robot-army/LoRaWAN_GPS/MiniUltraPro-master/MINI-ULTRA-PRO.pdf

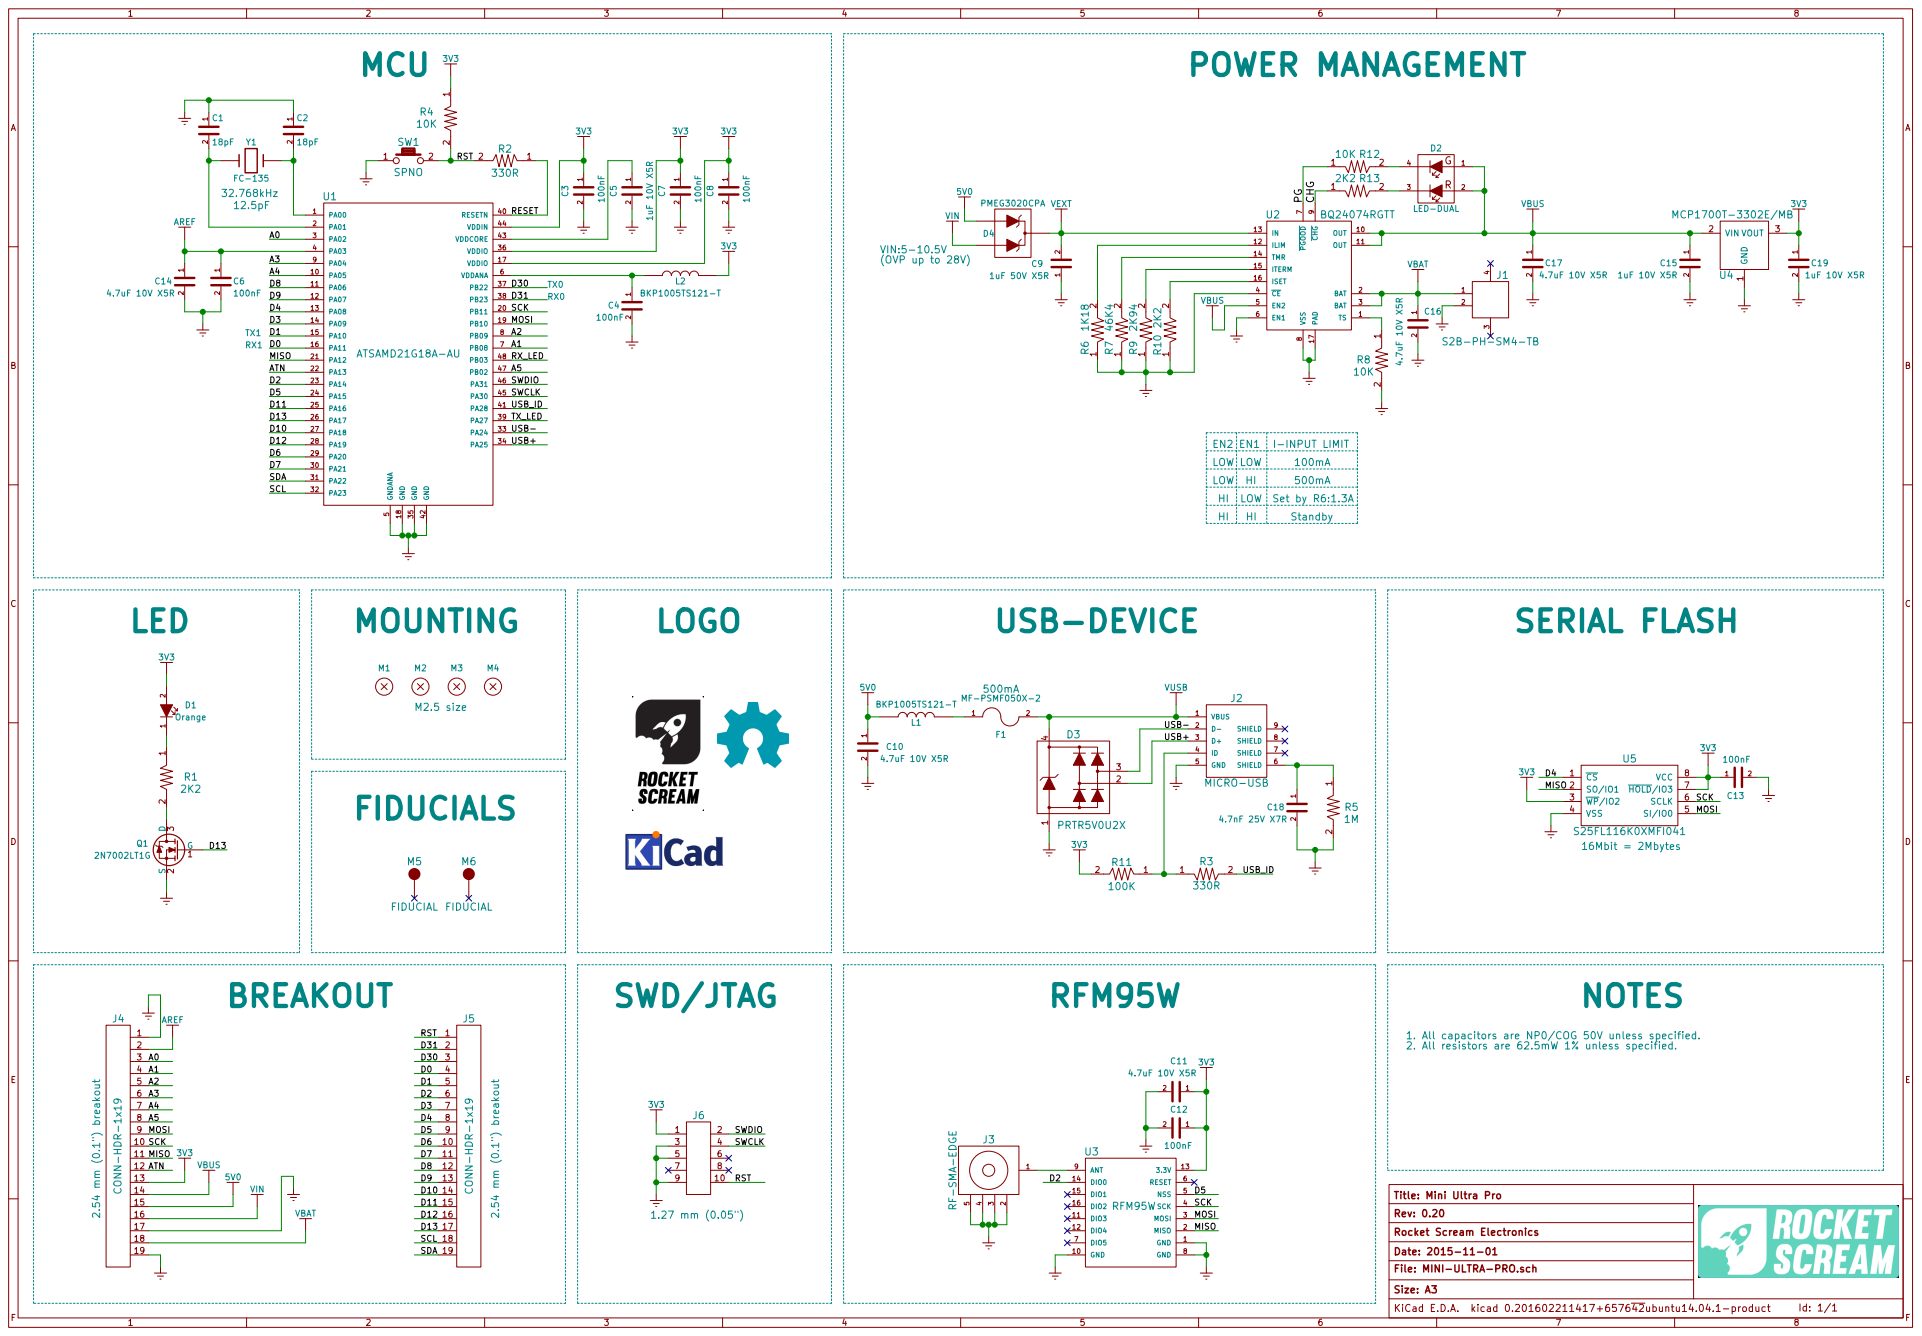
[picture p1: page 1]

5 VDDANA 6 PB08 7 PB09 8 PA04 9 PA05 10 PB11 20 PA21 30 RESETN 40 PA06 11 PA12 21 PA22 31 PA28 41 PA07 12 PA13 22 PA23 32 GND 42 PA08 13 PA14 23 PA24 33 VDDCORE 43 PA09 14 PA15 24 PA25 34 VDDIN 44 PA10 15 PA16 25 GND 35 PA30 45 PA11 16 PA17 26 VDDIO 36 PA31 46 VDDIO 17 PA18 27 PB22 37 PB02 47 GND 18 PA19 28 PB23 38 PB03 48 PB10 19 PA20 29 PA27 39 U1 ATSAMD21G18A-AU

100mA
500mA
Set by R6:1.3A

1. All capacitors are NP0/COG 50V unless specified.
2. All resistors are 62.5mW 1% unless specified.

Id: 1/1 Title: Mini Ultra Pro
F Date: 2015-11-01 KiCad E.D.A. kicad 0.201602211417+657642ubuntu14.04.1-product Rev: 0.20 Size: A3
File: MINI-ULTRA-PRO.sch Rocket Scream Electronics
