robot-army/LoRaWAN_GPS/lorawan_gps.kicad_pcb

## KiCad design lorawan_gps.kicad_pcb (2016-05-09)

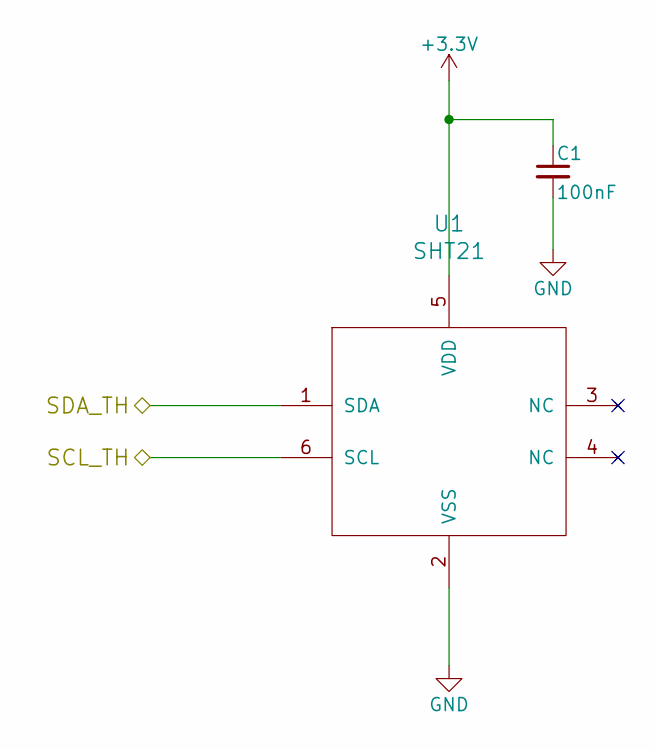
[picture p2: schematic TempHumidity.sch]

Parts:
C1: 100nF; C_0603
U1: SHT21

Connections:
/MCU/MPU_SCL: U1.6 (SCL); also elsewhere on the board
/MCU/MPU_SDA: U1.1 (SDA); also elsewhere on the board
GND: C1.2, U1.2 (VSS); also elsewhere on the board

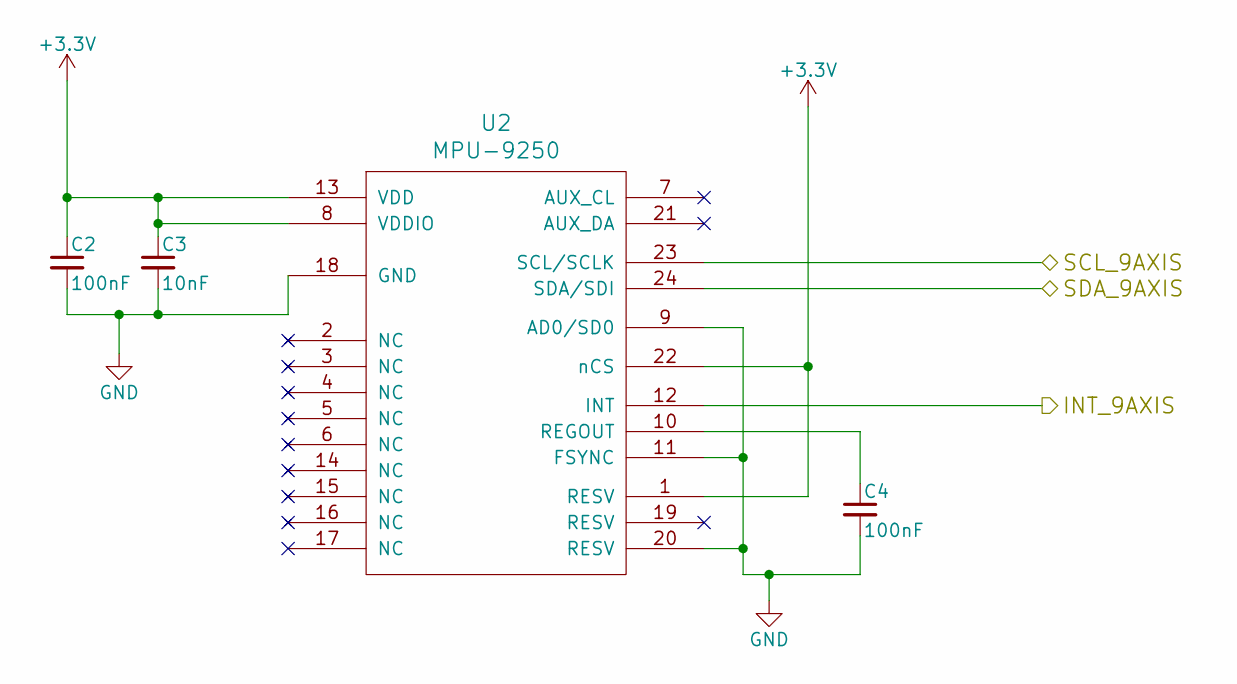
[picture p3: schematic 9axis.sch]

Parts:
C2, C4: 100nF; C_0603
C3: 10nF; C_0603
U2: MPU-9250; QFN-24-1EP_3x3mm_Pitch0.4mm

Connections:
/9axis/INT_9AXIS: U2.12 (INT); also elsewhere on the board
/MCU/MPU_SCL: U2.23 (SCL/SCLK); also elsewhere on the board
/MCU/MPU_SDA: U2.24 (SDA/SDI); also elsewhere on the board
GND: C2.2, C3.2, C4.2, U2.9 (AD0/SD0), U2.11 (FSYNC), U2.18 (GND), U2.20 (RESV); also elsewhere on the board
unnamed: C4.1, U2.10 (REGOUT)

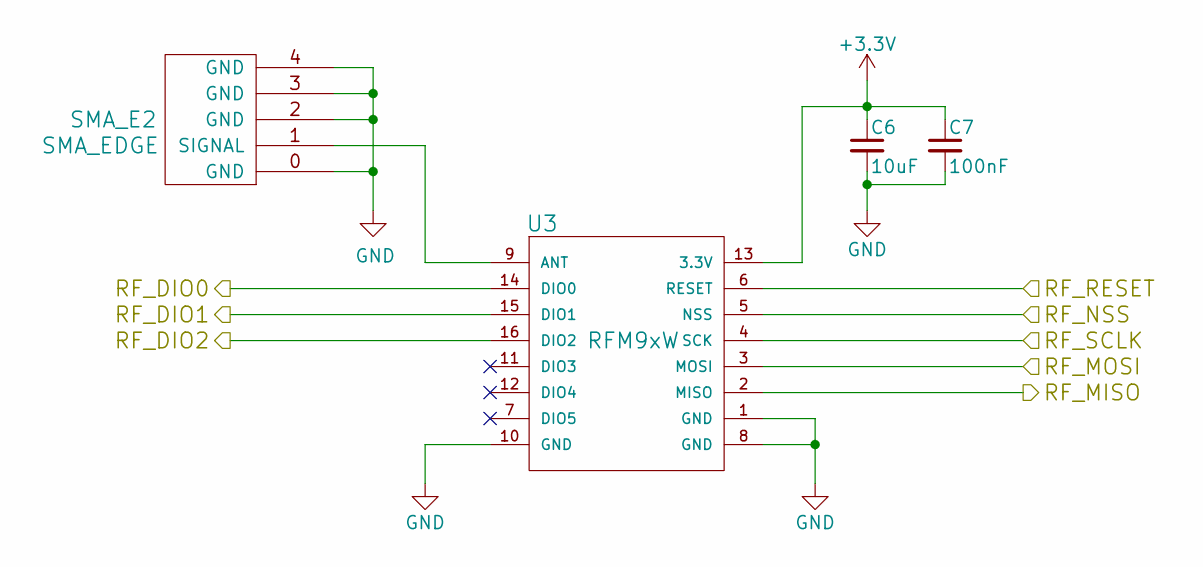
[picture p4: schematic LoRaWAN.sch]

Parts:
C6: 10uF; C_0805
C7: 100nF; C_0603
SMA_E2: SMA_EDGE
U3: RFM9xW

Connections:
/MCU/MPU_D14: U3.6 (RESET); also elsewhere on the board
/MCU/MPU_IN14: U3.15 (DIO1); also elsewhere on the board
/MCU/MPU_INT5: U3.16 (DIO2); also elsewhere on the board
/MCU/MPU_INT9: U3.14 (DIO0); also elsewhere on the board
/MCU/MPU_MISO: U3.2 (MISO); also elsewhere on the board
/MCU/MPU_MOSI: U3.3 (MOSI); also elsewhere on the board
/MCU/MPU_SCK: U3.4 (SCK); also elsewhere on the board
/MCU/MPU_SS: U3.5 (NSS); also elsewhere on the board
GND: C6.2, C7.2, SMA_E2.0 (GND), SMA_E2.2 (GND), SMA_E2.3 (GND), SMA_E2.4 (GND), U3.1 (GND), U3.8 (GND), U3.10 (GND); also elsewhere on the board
unnamed 22: SMA_E2.1 (SIGNAL), U3.9 (ANT); also elsewhere on the board

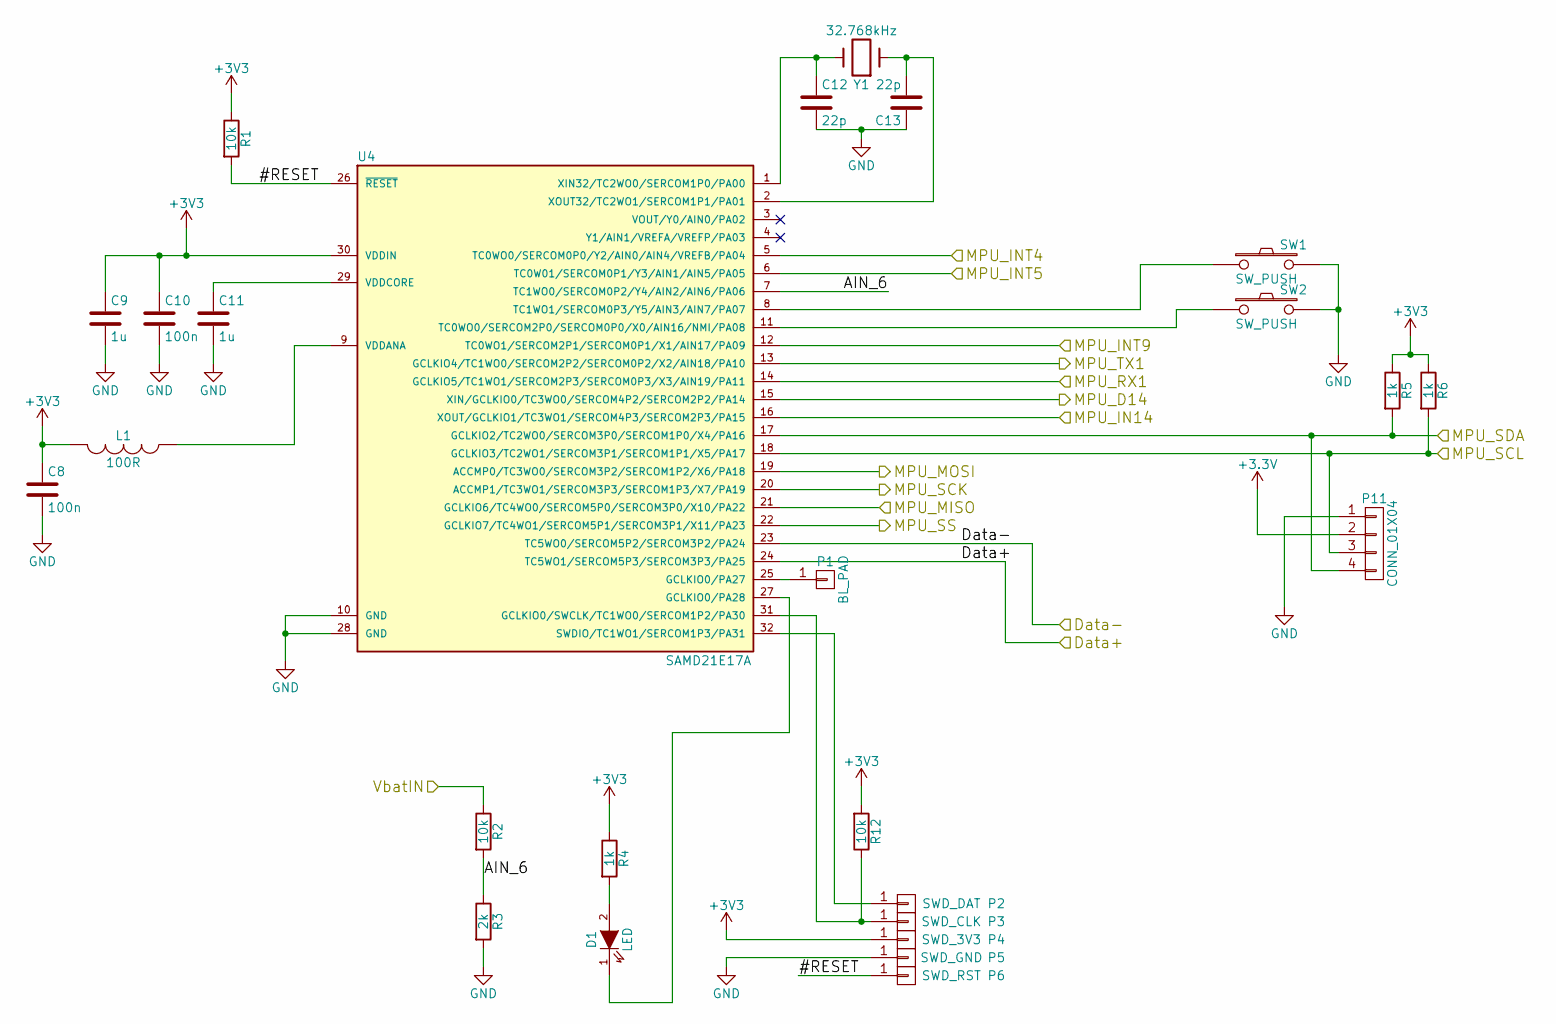
[picture p5: schematic MPU.sch]

Parts:
C8, C10: 100n; C_0603
C9, C11: 1u; C_0603
C12, C13: 22p; C_0603
D1: LED; C_0603
L1: 100R; C_0603
P1: BL_PAD; Measurement_Point_Round-TH_Small
P2: SWD_DAT; Measurement_Point_Round-TH_Small
P3: SWD_CLK; Measurement_Point_Round-TH_Small
P4: SWD_3V3; Measurement_Point_Round-TH_Small
P5: SWD_GND; Measurement_Point_Round-TH_Small
P6: SWD_RST; Measurement_Point_Round-TH_Small
P11: CONN_01X04; Pin_Header_Straight_1x04
R1, R2, R12: 10k; C_0603
R3: 2k; C_0603
R4, R5, R6: 1k; C_0603
SW1, SW2: SW_PUSH; SW_SPST_EVQP2
U4: SAMD21E17A; QFN-32-1EP_5x5mm_Pitch0.5mm
Y1: 32.768kHz; ABS07

Connections:
/9axis/INT_9AXIS: U4.5 (TC0WO0/SERCOM0P0/Y2/AIN0/AIN4/VREFB/PA04); also elsewhere on the board
/Battery and USB Connector/D+: U4.24 (TC5WO1/SERCOM5P3/SERCOM3P3/PA25); also elsewhere on the board
/Battery and USB Connector/D-: U4.23 (TC5WO0/SERCOM5P2/SERCOM3P2/PA24); also elsewhere on the board
/Battery and USB Connector/V_BAT: R2.1; also elsewhere on the board
/Battery and USB Connector/V_USB_Sense: U4.3 (VOUT/Y0/AIN0/PA02); also elsewhere on the board
/MCU/#RESET: P6.1, R1.2, U4.26 (~RESET~)
/MCU/AIN_6: R2.2, R3.1, U4.7 (TC1WO0/SERCOM0P2/Y4/AIN2/AIN6/PA06)
/MCU/MPU_D14: U4.15 (XIN/GCLKIO0/TC3WO0/SERCOM4P2/SERCOM2P2/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); also elsewhere on the board
/MCU/MPU_IN14: U4.16 (XOUT/GCLKIO1/TC3WO1/SERCOM4P3/SERCOM2P3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); also elsewhere on the board
/MCU/MPU_INT5: U4.6 (TC0W01/SERCOM0P1/Y3/AIN1/AIN5/PA05); also elsewhere on the board
/MCU/MPU_INT9: U4.12 (TC0WO1/SERCOM2P1/SERCOM0P1/X1/AIN17/PA09); also elsewhere on the board
/MCU/MPU_MISO: U4.21 (GCLKIO6/TC4WO0/SERCOM5P0/SERCOM3P0/X10/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); also elsewhere on the board
/MCU/MPU_MOSI: U4.19 (ACCMP0/TC3WO0/SERCOM3P2/SERCOM1P2/X6/PA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); also elsewhere on the board
/MCU/MPU_RX1: U4.14 (GCLKIO5/TC1WO1/SERCOM2P3/SERCOM0P3/X3/A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); also elsewhere on the board
/MCU/MPU_SCK: U4.20 (ACCMP1/TC3WO1/SERCOM3P3/SERCOM1P3/X7/PA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); also elsewhere on the board
/MCU/MPU_SCL: P11.3, R6.2, U4.18 (GCLKIO3/TC2WO1/SERCOM3P1/SERCOM1P1/X5/P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); also elsewhere on the board
/MCU/MPU_SDA: P11.4, R5.2, U4.17 (GCLKIO2/TC2WO0/SERCOM3P0/SERCOM1P0/X4/P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); also elsewhere on the board
/MCU/MPU_SS: U4.22 (GCLKIO7/TC4WO1/SERCOM5P1/SERCOM3P1/X11/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); also elsewhere on the board
/MCU/MPU_TX1: U4.13 (GCLKIO4/TC1WO0/SERCOM2P2/SERCOM0P2/X2/A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); also elsewhere on the board
GND: C8.2, C9.2, C10.2, C11.2, C12.2, C13.1, P5.1, P11.1, R3.2, SW1.2, SW2.2, U4.10 (GND), U4.28 (GND); also elsewhere on the board
unnamed: C11.1, U4.29 (VDDCORE)
unnamed: C12.1, U4.1 (XIN32/TC2WO0/SERCOM1P0/PA00), Y1.2
unnamed: C13.2, U4.2 (XOUT32/TC2WO1/SERCOM1P1/PA01), Y1.1
unnamed: D1.1 (K), U4.27 (GCLKIO0/PA28)
unnamed: D1.2 (A), R4.2
unnamed: L1.1, U4.9 (VDDANA)
unnamed: P1.1, U4.25 (GCLKIO0/PA27)
unnamed: P2.1, U4.32 (SWDIO/TC1WO1/SERCOM1P3/PA31)
unnamed: P3.1, R12.1, U4.31 (GCLKIO0/SWCLK/TC1WO0/SERCOM1P2/PA30)
unnamed: SW1.1, U4.8 (TC1WO1/SERCOM0P3/Y5/AIN3/AIN7/PA07)
unnamed: SW2.1, U4.11 (TC0WO0/SERCOM2P0/SERCOM0P0/X0/AIN16/NMI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)

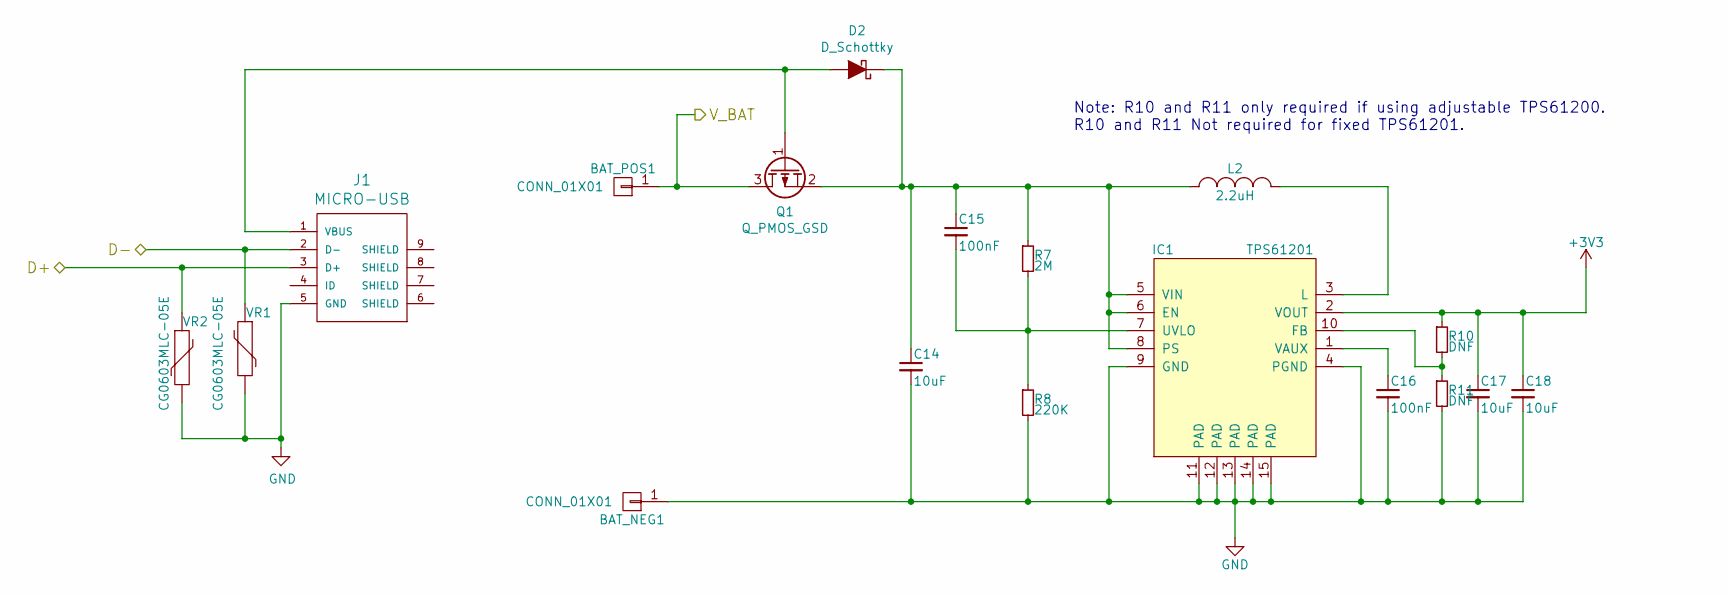
[picture p6: schematic Battery.sch]

Parts:
BAT_NEG1: CONN_01X01; Measurement_Point_Round-TH_Small
BAT_POS1: CONN_01X01; Measurement_Point_Round-TH_Small
C14, C17, C18: 10uF; C_0805
C15, C16: 100nF; C_0603
D2: D_Schottky; SOD-323; MFG Part Number MSS1P2L
IC1: TPS61201; VSON-10-1(4)EP_3x3mm_Pitch0.5mm
J1: MICRO-USB
L2: 2.2uH; Neosid_Inductor_SMS-ME3015
Q1: Q_PMOS_GSD; SOT-23; MFG Part Number FDN340P
R7: 2M; C_0603
R8: 220K; C_0603
R10, R11: DNF; C_0603
VR1, VR2: CG0603MLC-05E; C_0603

Connections:
/Battery and USB Connector/D+: J1.3 (D+), VR2.1; also elsewhere on the board
/Battery and USB Connector/D-: J1.2 (D-), VR1.1; also elsewhere on the board
/Battery and USB Connector/V_BAT: BAT_POS1.1, Q1.3 (D); also elsewhere on the board
GND: BAT_NEG1.1, C14.2, C16.2, C17.2, C18.2, IC1.4 (PGND), IC1.9 (GND), IC1.11 (PAD), IC1.12 (PAD), IC1.13 (PAD), IC1.14 (PAD), IC1.15 (PAD), J1.5 (GND), R8.2, R11.2, VR1.2, VR2.2; also elsewhere on the board
unnamed: C14.1, C15.1, D2.1 (K), IC1.5 (VIN), IC1.6 (EN), IC1.8 (PS), L2.1, Q1.2 (S), R7.1
unnamed: C15.2, IC1.7 (UVLO), R7.2, R8.1
unnamed: C16.1, IC1.1 (VAUX)
unnamed 32: D2.2 (A), J1.1 (VBUS), Q1.1 (G); also elsewhere on the board
unnamed: IC1.3 (L), L2.2
unnamed: IC1.10 (FB), R10.2, R11.1

Notes on the sheet:
Note: R10 and R11 only required if using adjustable TPS61200. R10 and R11 Not required for fixed TPS61201.

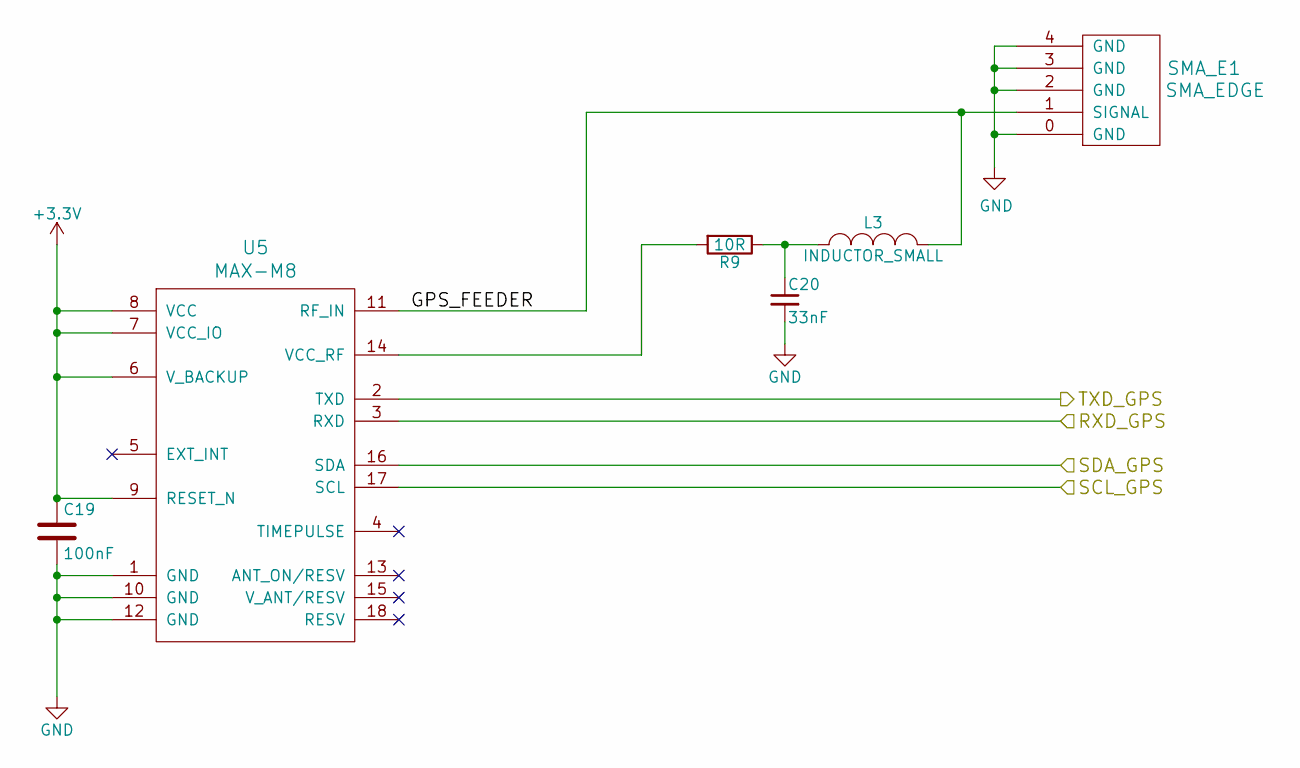
[picture p7: schematic GPS.sch]

Parts:
C19: 100nF; C_0603
C20: 33nF; C_0603
L3: INDUCTOR_SMALL; C_0603
R9: 10R; C_0603
SMA_E1: SMA_EDGE
U5: MAX-M8

Connections:
/GPS/GPS_FEEDER: L3.2, SMA_E1.1 (SIGNAL), U5.11 (RF_IN); also elsewhere on the board
/MCU/MPU_RX1: U5.2 (TXD); also elsewhere on the board
/MCU/MPU_SCL: U5.17 (SCL); also elsewhere on the board
/MCU/MPU_SDA: U5.16 (SDA); also elsewhere on the board
/MCU/MPU_TX1: U5.3 (RXD); also elsewhere on the board
GND: C19.2, C20.2, SMA_E1.0 (GND), SMA_E1.2 (GND), SMA_E1.3 (GND), SMA_E1.4 (GND), U5.1 (GND), U5.10 (GND), U5.12 (GND); also elsewhere on the board
unnamed: C20.1, L3.1, R9.1
unnamed: R9.2, U5.14 (VCC_RF)

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
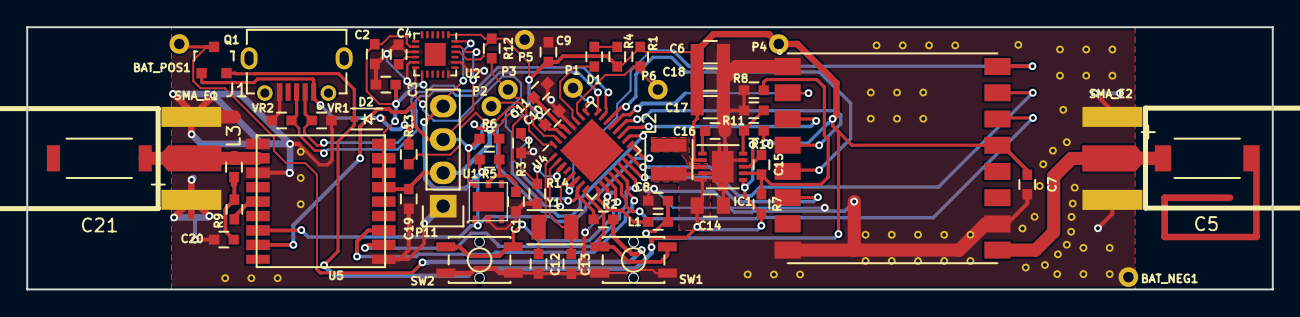
[picture p8: board lorawan_gps.kicad_pcb from above]

Board: 2 copper layers, 95.0 x 20.0 mm, 64 parts (0 on the bottom side), 43 nets.

Other parts of the board:
C5: CP; 0868AT43A0020
C21: CP; 1575AT43A0040
R13, R14: R; C_0603

Their connections:
/Battery and USB Connector/V_USB_Sense: R13.2, R14.1; also elsewhere on the board
/GPS/GPS_FEEDER: C21.1; also elsewhere on the board
GND: R14.2; also elsewhere on the board
unnamed 22: C5.1; also elsewhere on the board
unnamed 32: R13.1; also elsewhere on the board
