robot-army/LoRaWAN_GPS/MiniUltraPro-master/MINI-ULTRA-PRO.kicad_pcb

## KiCad design MiniUltraPro-master/MINI-ULTRA-PRO.kicad_pcb (2016-03-24)

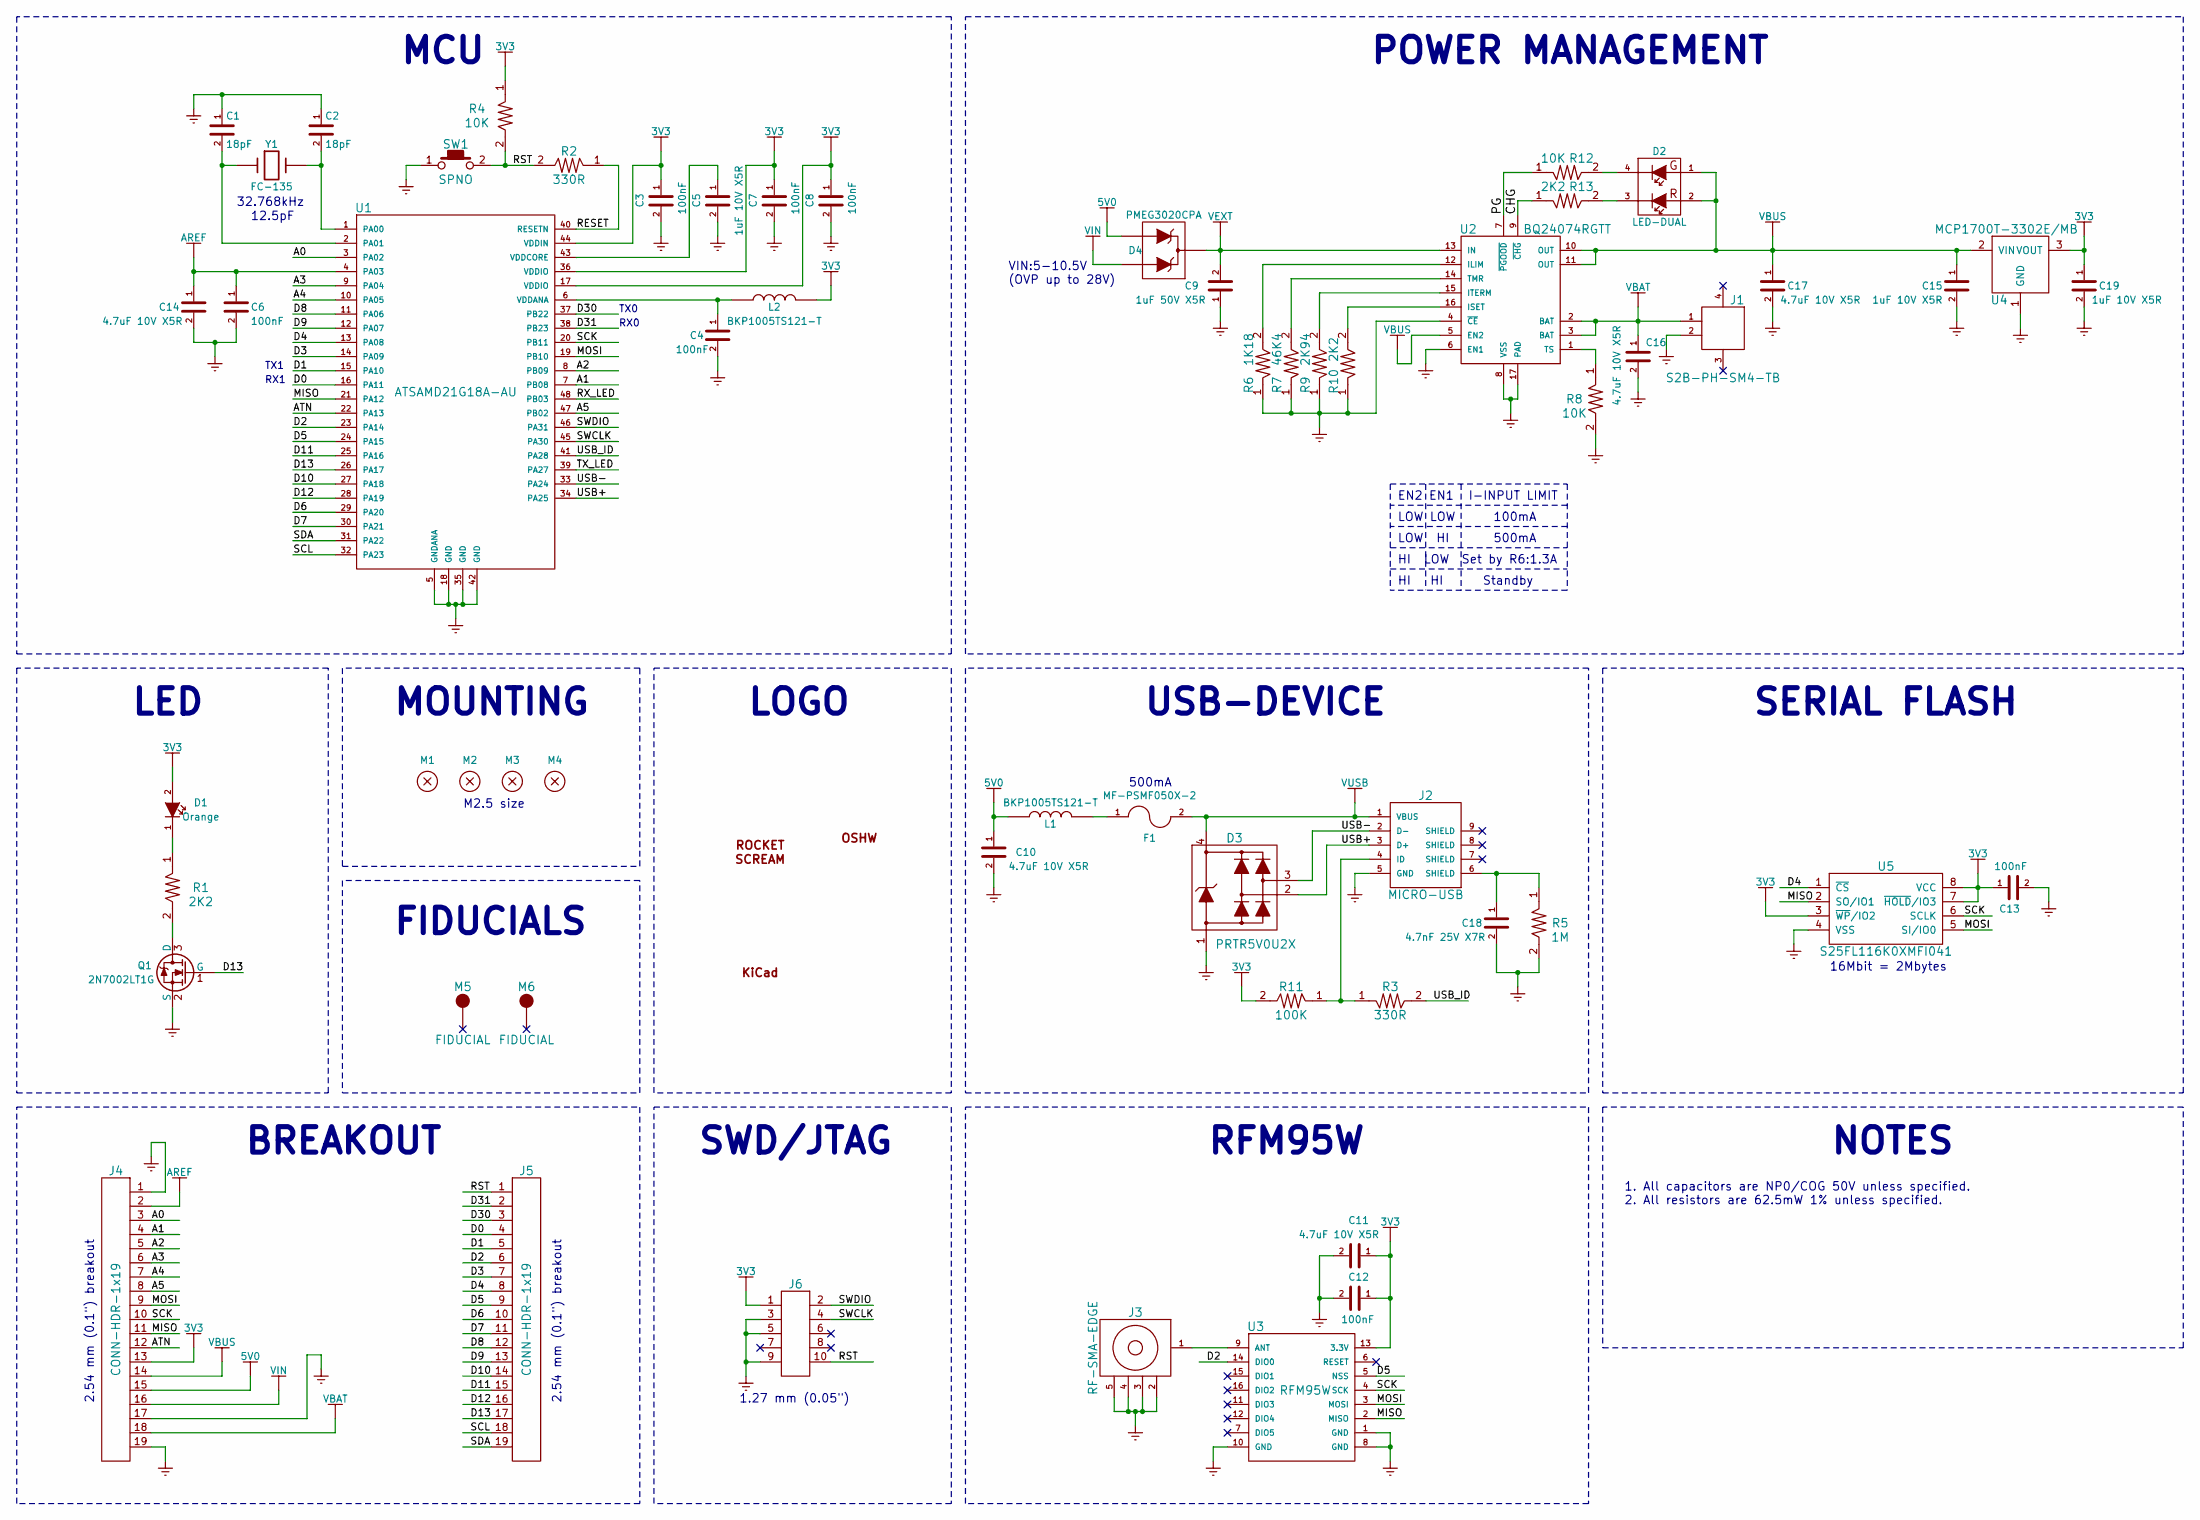
[picture p9: schematic MINI-ULTRA-PRO.sch, Mini Ultra Pro]

Parts:
C1, C2: 18pF; CAP-0402
C3, C4, C6, C7, C8, C12, C13: 100nF; CAP-0402
C5, C15, C19: 1uF 10V X5R; CAP-0402
C9: 1uF 50V X5R; CAP-0603
C10, C11, C14, C16, C17: 4.7uF 10V X5R; CAP-0402
C18: 4.7nF 25V X7R; CAP-0402
D1: Orange; LED-0603
D2: LED-DUAL; LED-1615
D3: PRTR5V0U2X; SOT-143B
D4: PMEG3020CPA; SOT-1016
F1: MF-PSMF050X-2; MF-PSMF020X
J1: S2B-PH-SM4-TB
J2: MICRO-USB
J3: RF-SMA-EDGE
J4, J5: CONN-HDR-1x19; HDR_1x19_Pitch2.54mm_WithoutSilk
J6: CONN-HDR-2x5; HDR_2x5_Pitch1.27mm
L1, L2: BKP1005TS121-T; IND-0402
LOGO1: LOGO-ROCKET-SCREAM; LOGO-ROCKET-SCREAM_Vertical_Small
LOGO2: LOGO-OSHW; LOGO-OSHW_Small
LOGO3: LOGO-KICAD; LOGO-KICAD_XSmall
M1, M2, M3, M4: MOUNT_HOLE; HOLE_NPTH_2.2MM
M5, M6: FIDUCIAL; FIDUCIAL-1MM
Q1: 2N7002LT1G; SOT-23
R1, R10, R13: 2K2; RES-0402
R2, R3: 330R; RES-0402
R4, R8, R12: 10K; RES-0402
R5: 1M; RES-0402
R6: 1K18; RES-0402
R7: 46K4; RES-0402
R9: 2K94; RES-0402
R11: 100K; RES-0402
SW1: SPNO; TS-018
U1: ATSAMD21G18A-AU; TQFP-48_7x7mm_Pitch0.5mm
U2: BQ24074RGTT; QFN-16_3x3mm
U3: RFM95W; RFM9xW
U4: MCP1700T-3302E/MB; SOT-89
U5: S25FL116K0XMFI041; SOIC-8-N
Y1: FC-135; ABS07

Connections:
3V3: C3.1, C7.1, C8.1, C11.1, C12.1, C13.1, C19.1, D1.2 (A), J4.13, J6.1, L2.2, R4.1, R11.2, U1.17 (VDDIO), U1.36 (VDDIO), U1.44 (VDDIN), U3.13 (3.3V), U4.3 (VOUT), U5.3 (~WP~/IO2), U5.7 (~HOLD~/IO3), U5.8 (VCC)
5V0: C10.1, D4.1 (A), J4.15, L1.1
/A0: J4.3, U1.3 (PA02)
/A1: J4.4, U1.7 (PB08)
/A2: J4.5, U1.8 (PB09)
/A3: J4.6, U1.9 (PA04)
/A4: J4.7, U1.10 (PA05)
/A5: J4.8, U1.47 (PB02)
/ATN: J4.12, U1.22 (PA13)
/CHG: R13.1, U2.9 (~CHG~)
/D0: J5.4, U1.16 (PA11)
/D1: J5.5, U1.15 (PA10)
/D2: J5.6, U1.23 (PA14), U3.14 (DIO0)
/D3: J5.7, U1.14 (PA09)
/D4: J5.8, U1.13 (PA08), U5.1 (~CS~)
/D5: J5.9, U1.24 (PA15), U3.5 (NSS)
/D6: J5.10, U1.29 (PA20)
/D7: J5.11, U1.30 (PA21)
/D8: J5.12, U1.11 (PA06)
/D9: J5.13, U1.12 (PA07)
/D10: J5.14, U1.27 (PA18)
/D11: J5.15, U1.25 (PA16)
/D12: J5.16, U1.28 (PA19)
/D13: J5.17, Q1.1 (G), U1.26 (PA17)
/D30: J5.3, U1.37 (PB22)
/D31: J5.2, U1.38 (PB23)
/MISO: J4.11, U1.21 (PA12), U3.2 (MISO), U5.2 (SO/IO1)
/MOSI: J4.9, U1.19 (PB10), U3.3 (MOSI), U5.5 (SI/IO0)
/PG: R12.1, U2.7 (~PGOOD~)
/RESET: R2.1, U1.40 (RESETN)
/RST: J5.1, J6.10, R2.2, R4.2, SW1.2
/RX_LED: U1.48 (PB03)
/SCK: J4.10, U1.20 (PB11), U3.4 (SCK), U5.6 (SCLK)
/SCL: J5.18, U1.32 (PA23)
/SDA: J5.19, U1.31 (PA22)
/SWCLK: J6.4, U1.45 (PA30)
/SWDIO: J6.2, U1.46 (PA31)
/TX_LED: U1.39 (PA27)
/USB+: D3.2, J2.3 (D+), U1.34 (PA25)
/USB-: D3.3, J2.2 (D-), U1.33 (PA24)
/USB_ID: R3.2, U1.41 (PA28)
AREF: C6.1, C14.1, J4.2, U1.4 (PA03)
GND: C1.1, C2.1, C3.2, C4.2, C5.2, C6.2, C7.2, C8.2, C9.1, C10.2, C11.2, C12.2, C13.2, C14.2, C15.2, C16.2, C17.2, C18.2, C19.2, D3.1, J1.2, J2.5 (GND), J3.2, J3.3, J3.4, J3.5, J4.1, J4.17, J4.19, J6.3, J6.5, J6.9, Q1.2 (S), R5.2, R6.1, R7.1, R8.2, R9.1, R10.1, SW1.1, U1.5 (GNDANA), U1.18 (GND), U1.35 (GND), U1.42 (GND), U2.4 (~CE~), U2.6 (EN1), U2.8 (VSS), U2.17 (PAD), U3.1 (GND), U3.8 (GND), U3.10 (GND), U4.1 (GND), U5.4 (VSS)
unnamed: C1.2, U1.2 (PA01), Y1.1
unnamed: C2.2, U1.1 (PA00), Y1.2
unnamed: C4.1, L2.1, U1.6 (VDDANA)
unnamed: C5.1, U1.43 (VDDCORE)
unnamed: C18.1, J2.6 (SHIELD), R5.1
unnamed: D1.1 (K), R1.1
unnamed: D2.3 (K), R13.2
unnamed: D2.4 (K), R12.2
unnamed: F1.1, L1.2
unnamed: J2.4 (ID), R3.1, R11.1
unnamed: J3.1, U3.9 (ANT)
unnamed: Q1.3 (D), R1.2
unnamed: R6.2, U2.12 (ILIM)
unnamed: R7.2, U2.14 (TMR)
unnamed: R8.1, U2.1 (TS)
unnamed: R9.2, U2.15 (ITERM)
unnamed: R10.2, U2.16 (ISET)
VBAT: C16.1, J1.1, J4.18, U2.2 (BAT), U2.3 (BAT)
VBUS: C15.1, C17.1, D2.1 (A), D2.2 (A), J4.14, U2.5 (EN2), U2.10 (OUT), U2.11 (OUT), U4.2 (VIN)
VEXT: C9.2, D4.3 (K), U2.13 (IN)
VIN: D4.2 (A), J4.16
VUSB: D3.4, F1.2, J2.1 (VBUS)

Notes on the sheet:
LOGO
MOUNTING
FIDUCIALS
SWD/JTAG
BREAKOUT
LED
RFM95W
SERIAL FLASH
POWER MANAGEMENT
USB-DEVICE
MCU
TX0
RX0
RX1
TX1
VIN:5-10.5V (OVP up to 28V)
NOTES
1. All capacitors are NP0/COG 50V unless specified. 2. All resistors are 62.5mW 1% unless specified.
16Mbit = 2Mbytes
M2.5 size
2.54 mm (0.1") breakout
1.27 mm (0.05")
EN2 EN1
LOW LOW
LOW HI
HI LOW
HI HI
I-INPUT LIMIT
100mA
500mA
Set by R6:1.3A
Standby
32.768kHz
12.5pF

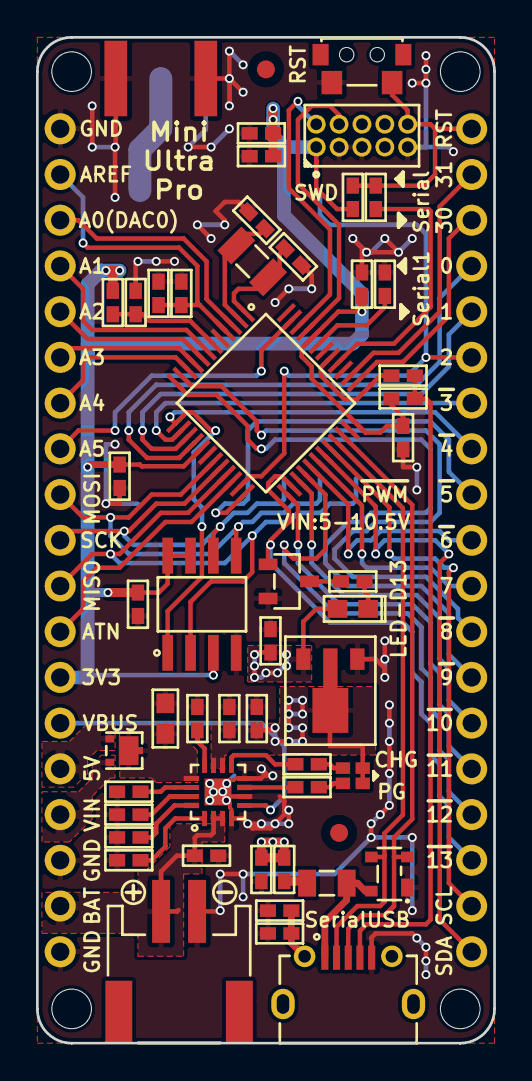
[picture p10: board MINI-ULTRA-PRO.kicad_pcb from above]

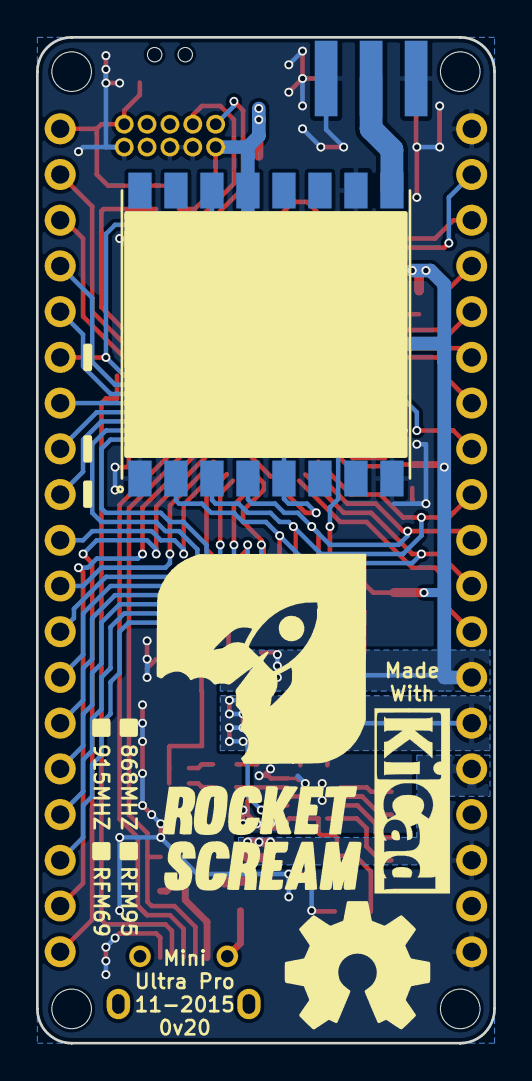
[picture p11: board MINI-ULTRA-PRO.kicad_pcb from below]

Board: 2 copper layers, 25.4 x 55.9 mm, 62 parts (5 on the bottom side), 63 nets.
