robot-army/LoRaWAN_GPS/(commit log)

2016-03-06 Added SAMD21 processor and associated bits from other project
    [file56C10DB3.sch]
2016-03-06 Added outline for AAA battery size
    [file56C10DB3.sch, file56DB6601.sch, file56DB69AA.sch, file56DB718C.sch, file56DB96DB.sch, lorawan_gps.kicad_pcb, lorawan_gps.sch]
2016-03-24 started layout, completed schematic
    [9axis.sch, Battery.sch, GPS.sch, LoRaWAN.sch, MINI-ULTRA-PRO.kicad_pcb, MINI-ULTRA-PRO.sch, MPU.sch, TempHumid.sch]
2016-03-25 All connected
    [lorawan_gps.kicad_pcb]
2016-03-25 Added edge-mount SMAs
    [9axis.sch, Battery.sch, GPS.sch, LoRaWAN.sch, MPU.sch, TempHumidity.sch, lorawan_gps.kicad_pcb, lorawan_gps.sch]
2016-03-25 Added Edge-mount SMA connectors to layout - NOTE: 1 UNCONNECT
    [lorawan_gps.kicad_pcb]
2016-03-28 moved battery input and fixed dodgy ground plane
    [9axis.sch, Battery.sch, GPS.sch, LoRaWAN.sch, MPU.sch, TempHumidity.sch, lorawan_gps.kicad_pcb]
2016-03-28 Changed L3 to 0603, L2 to 3x3, Fixed P8 silk and made gerbers
    [lorawan_gps-B.Cu.gbl, lorawan_gps-B.Mask.gbs, lorawan_gps-B.SilkS.gbo, lorawan_gps-Edge.Cuts.gm1, lorawan_gps-F.Cu.gtl, lorawan_gps-F.Mask.gts, lorawan_gps-F.SilkS.gto, lorawan_gps-NPTH.drl]
2016-04-03 Started changes after first round, micro usb connector, fixing footprint for accelerometer
    [9axis.sch, GPS.sch, LoRaWAN.sch, MPU.sch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]
2016-04-19 Started work to add the power mux and USB connector
    [Battery.sch, GPS.sch, MPU.sch, lorawan_gps.kicad_pcb, lorawan_gps.sch]
2016-05-09 Added USB connector, diode or etc to layout@
    [Battery.sch, GPS.sch, MPU.sch, lorawan_gps.kicad_pcb, lorawan_gps.sch]
2016-05-09 Fixed track near edge by accelerometer
    [lorawan_gps-B.Cu.gbl, lorawan_gps-B.Mask.gbs, lorawan_gps-B.Paste.gbp, lorawan_gps-B.SilkS.gbo, lorawan_gps-Edge.Cuts.gm1, lorawan_gps-F.Cu.gtl, lorawan_gps-F.Mask.gts, lorawan_gps-F.Paste.gtp]
2016-05-09 Added dielectric antennae, finished wiring, DRC pass, no unconnects
    [GPS.sch, LoRaWAN.sch, lorawan_gps.kicad_pcb]
2016-05-11 Added USB monitoring resistors, still need to set values. Also added stitching vias and tried to clean up some layout
    [9axis.sch, Battery.sch, GPS.sch, LoRaWAN.sch, MPU.sch, TempHumidity.sch, lorawan_gps.kicad_pcb, lorawan_gps.sch]
2016-05-12 Fixed layout, updated RF track width, switch footprint fixed, layout around accelerometer fixed
    [lorawan_gps.kicad_pcb]
2016-05-12 Fixed up silkscreen
    [lorawan_gps.kicad_pcb]
2016-05-12 Fixed up silkscreen some more
    [lorawan_gps.kicad_pcb]
2016-05-12 Added BOM, new gerbers
    [lorawan_gps-B.Cu.gbl, lorawan_gps-B.Mask.gbs, lorawan_gps-B.Paste.gbp, lorawan_gps-Edge.Cuts.gm1, lorawan_gps-F.Cu.gtl, lorawan_gps-F.Mask.gts, lorawan_gps-F.Paste.gtp, lorawan_gps-F.SilkS.gto]
2016-05-12 Fixed single bad unconnect
    [lorawan_gps-B.Cu.gbl, lorawan_gps-B.Mask.gbs, lorawan_gps-B.Paste.gbp, lorawan_gps-B.SilkS.gbo, lorawan_gps-Edge.Cuts.gm1, lorawan_gps-F.Cu.gtl, lorawan_gps-F.Mask.gts, lorawan_gps-F.Paste.gtp]
